brenchies/SurfsideSensors/schematics/hardware/Air Quality Sensor docs/PCB Wiring diagram back & front.jpg

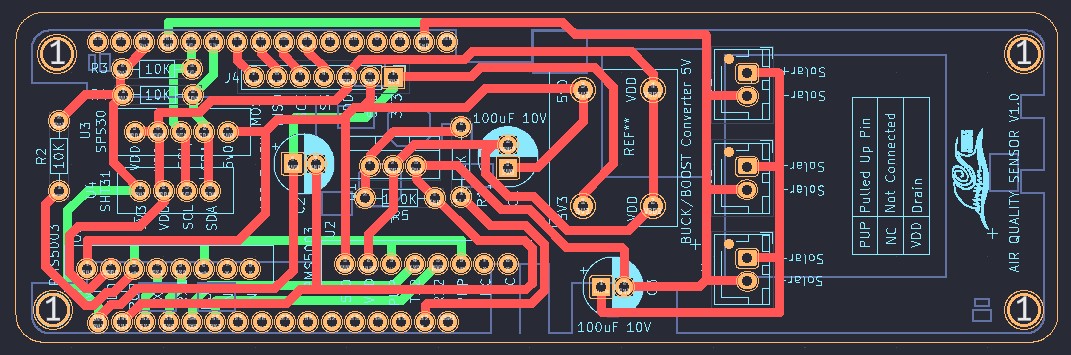
schematics/hardware/Air Quality Sensor docs/PCB Wiring diagram back & front.jpg
