brenchies/SurfsideSensors/schematics/hardware/Air Quality Sensor docs/Air Quality Sensor Wiring Fritzing_bbfinal.jpg

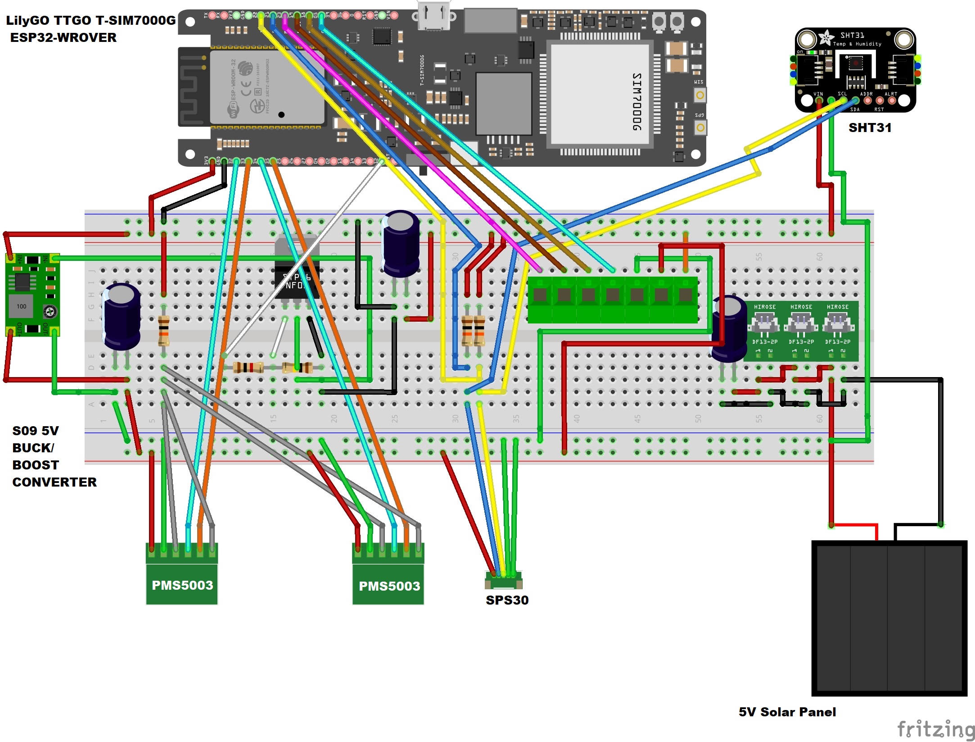
schematics/hardware/Air Quality Sensor docs/Air Quality Sensor Wiring Fritzing_bbfinal.jpg
