brenchies/SurfsideSensors/schematics/hardware/Air Quality Sensor docs/AQ CAD files/AQM (Stephen Design) (4).stl

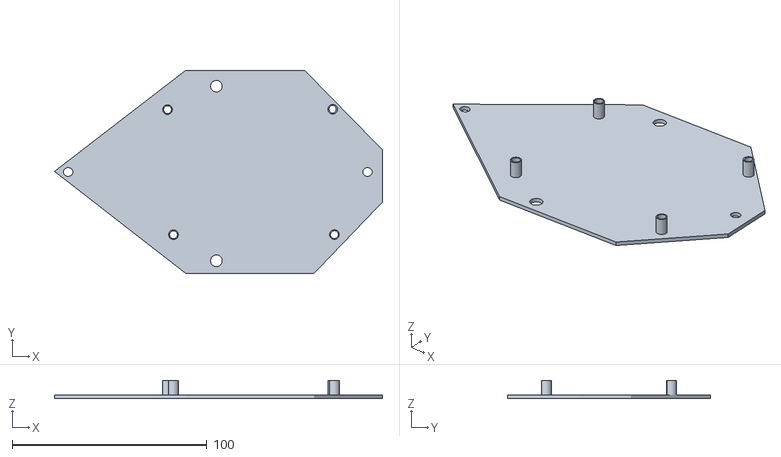
[picture p3: CAD file, 2023-05-29]
schematics/hardware/Air Quality Sensor docs/AQ CAD files/AQM (Stephen Design) (4).stl
168.4 x 104.0 x 9.50
