brenchies/SurfsideSensors/schematics/hardware/waterquality CAD files/WAP Top v4.stl

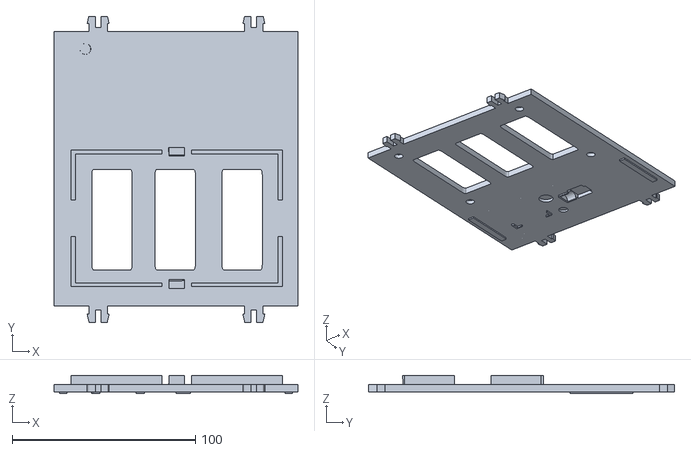
[picture p4: CAD file, 2023-05-29]
schematics/hardware/waterquality CAD files/WAP Top v4.stl
133.0 x 167.0 x 10.00
