brenchies/SurfsideSensors/schematics/hardware/waterquality CAD files/WAPv2 bottom plate v3(1).stl

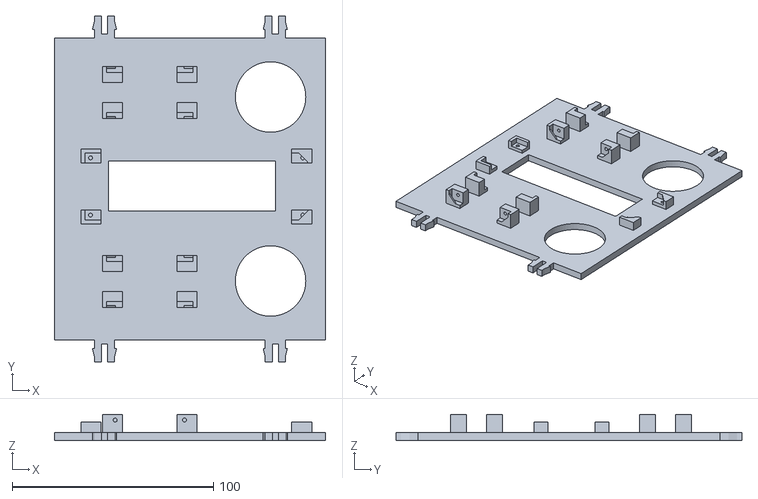
[picture p5: CAD file, 2023-05-29]
schematics/hardware/waterquality CAD files/WAPv2 bottom plate v3(1).stl
134.9 x 172.0 x 13.0
