brenchies/SurfsideSensors/schematics/hardware/waterquality CAD files/meta legs(1).stl

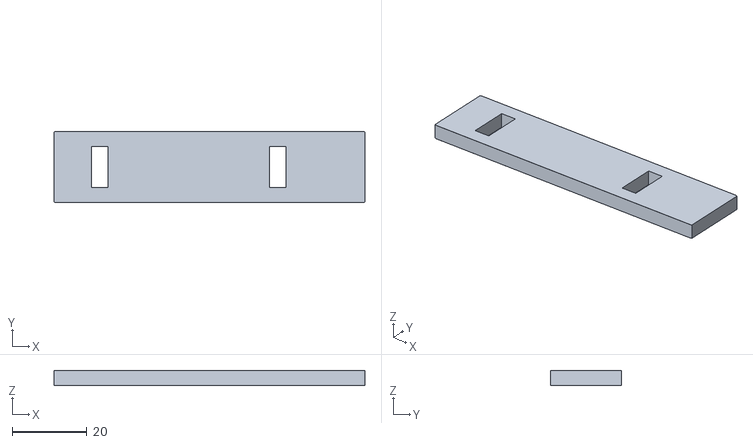
[picture p6: CAD file, 2023-05-29]
schematics/hardware/waterquality CAD files/meta legs(1).stl
83.2 x 19.0 x 4.00
