brenchies/SurfsideSensors/schematics/hardware/Air Quality Sensor docs/PCB Wiring diagram AQS [Components and pinouts].jpg

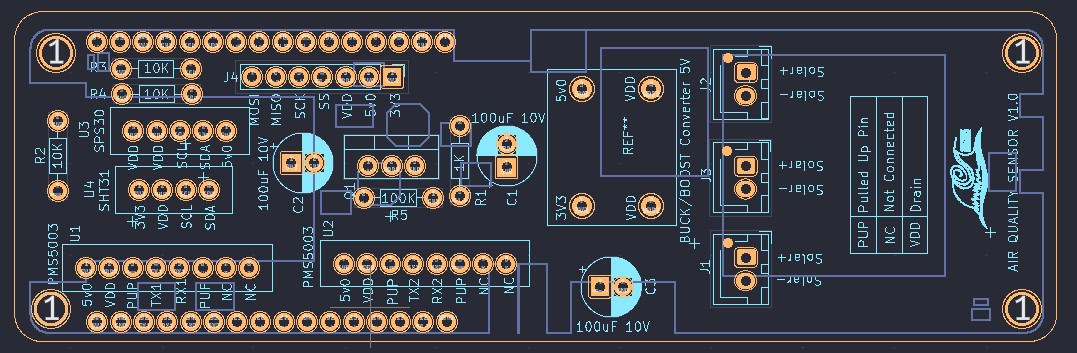
schematics/hardware/Air Quality Sensor docs/PCB Wiring diagram AQS [Components and pinouts].jpg
