brenchies/SurfsideSensors/schematics/hardware/Air Quality Sensor docs/PCB Wiring diagram back.jpg

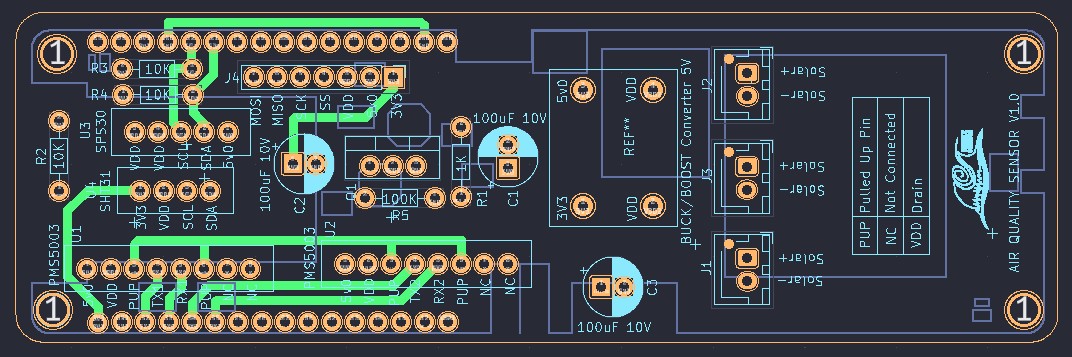
schematics/hardware/Air Quality Sensor docs/PCB Wiring diagram back.jpg
