brenchies/SurfsideSensors/schematics/hardware/waterquality CAD files/water_quality_shield_circuit_diagram.pdf

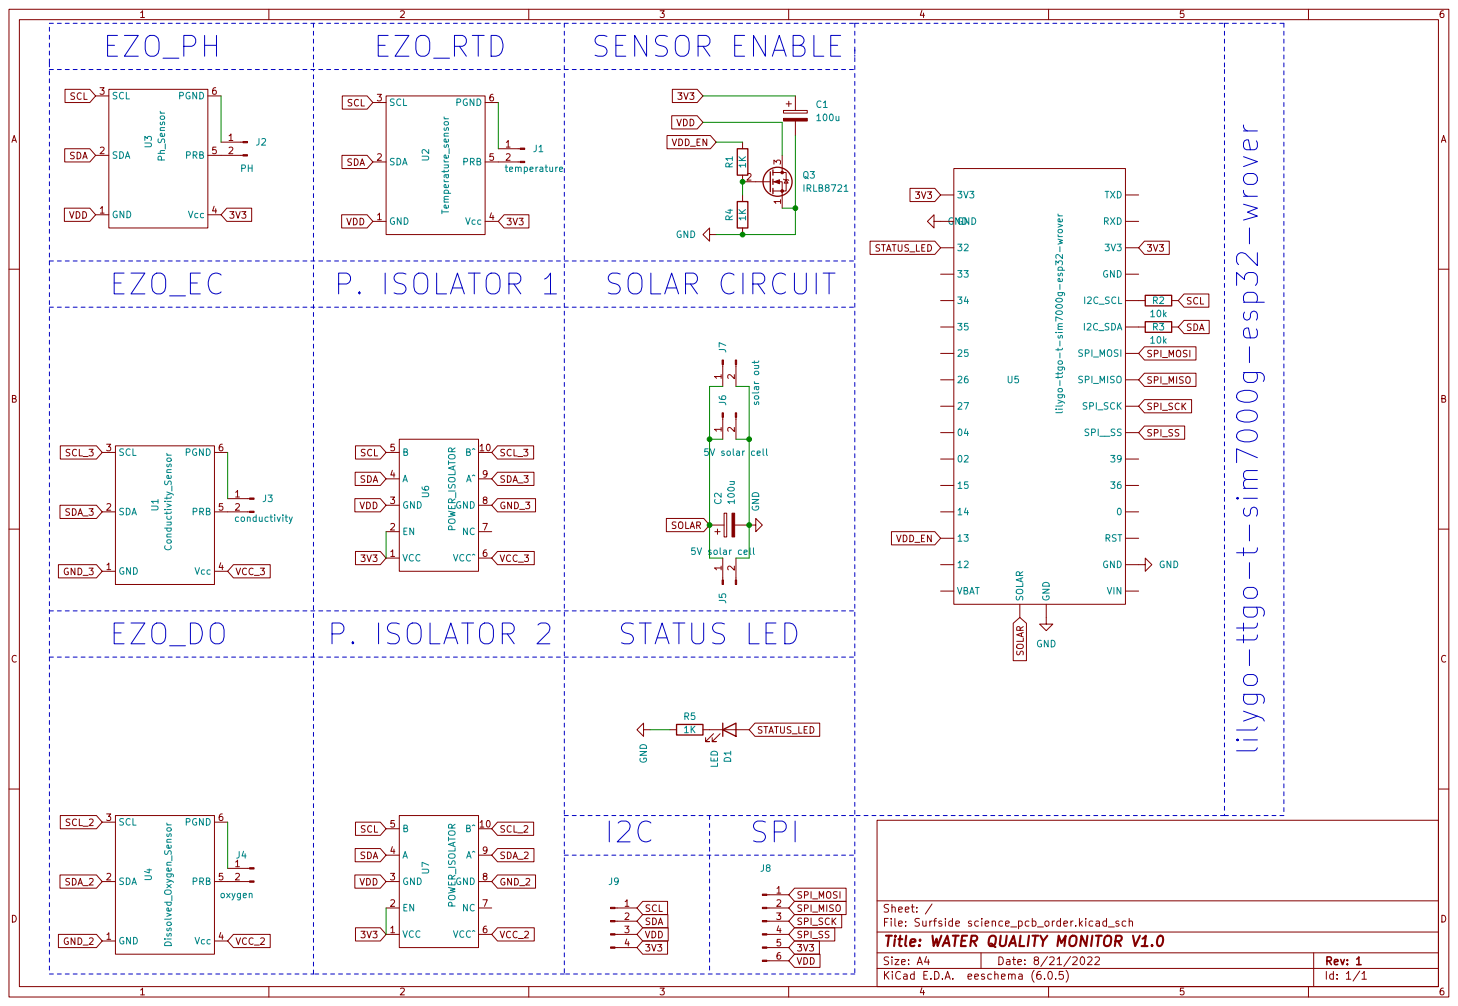
[picture p9: page 1]

GND 1 SDA 2 SCL 3 Vcc 4 PRB 5 PGND 6 U3 Ph_Sensor | GND 12

EZO_EC

EZO_DO | | J9 12 STATUS LED | J8 C2100u R5

3V3 VDD

SCL | SPI_MOSI SPI_SCK SPI_SS 3V3 VDD

Id: 1/1 Title: WATER QUALITY MONITOR V1.0
