brenchies/SurfsideSensors/schematics/software/Software architecture.pdf

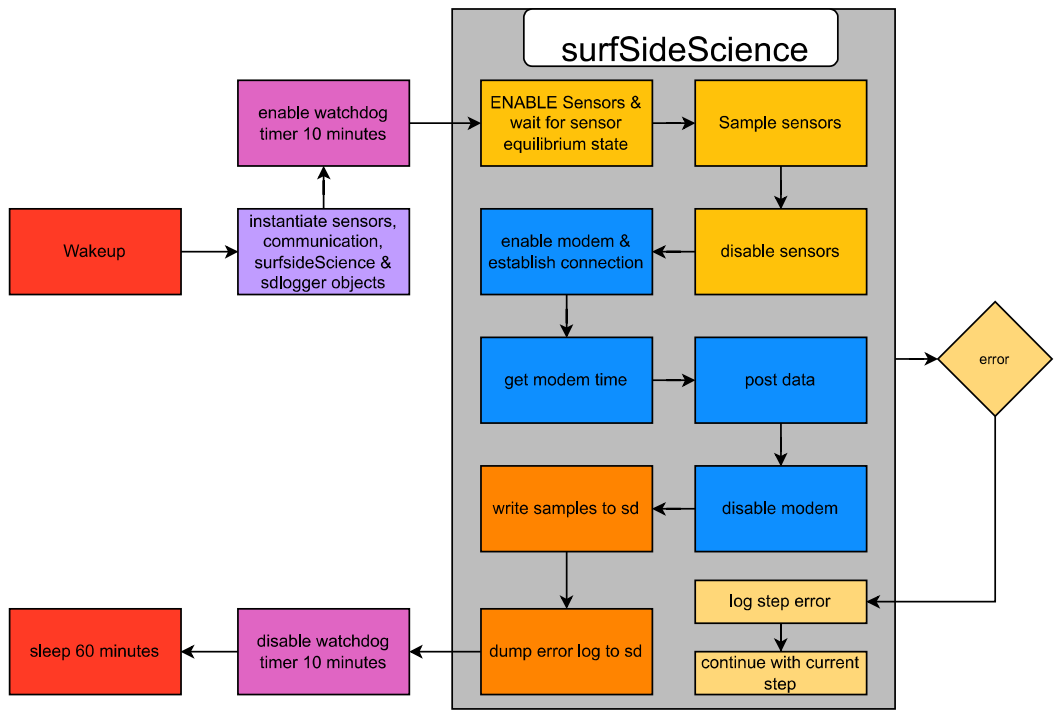
[picture p10: page 1]

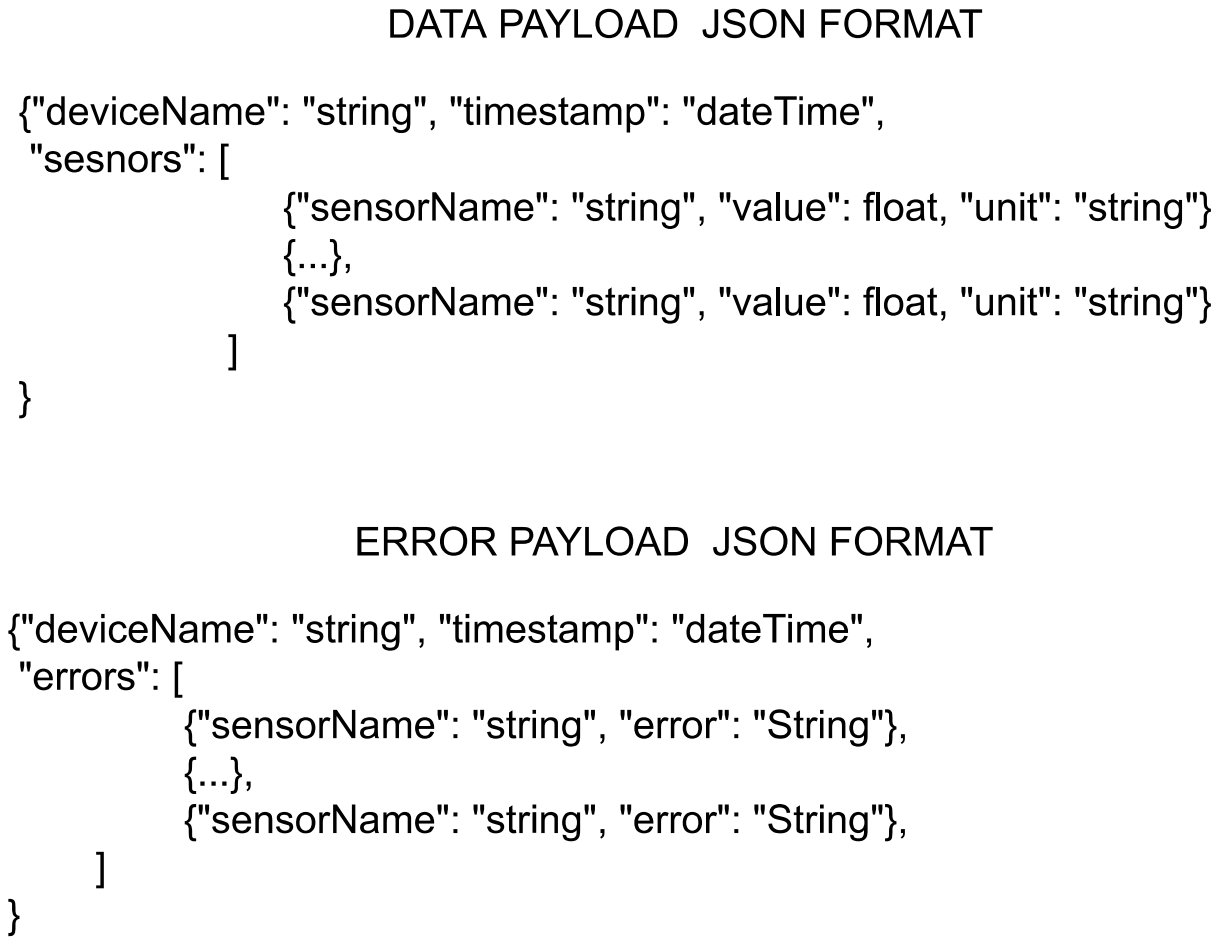
[picture p11: page 3]

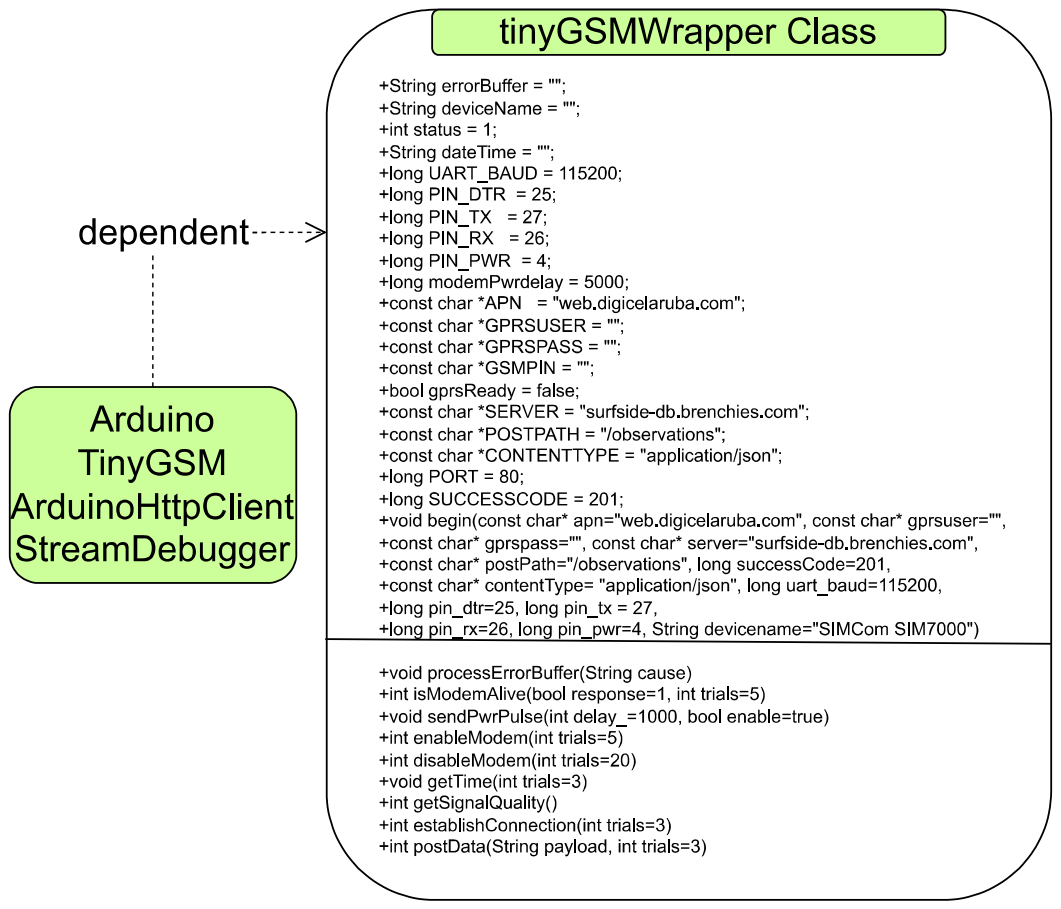
[picture p12: page 5]

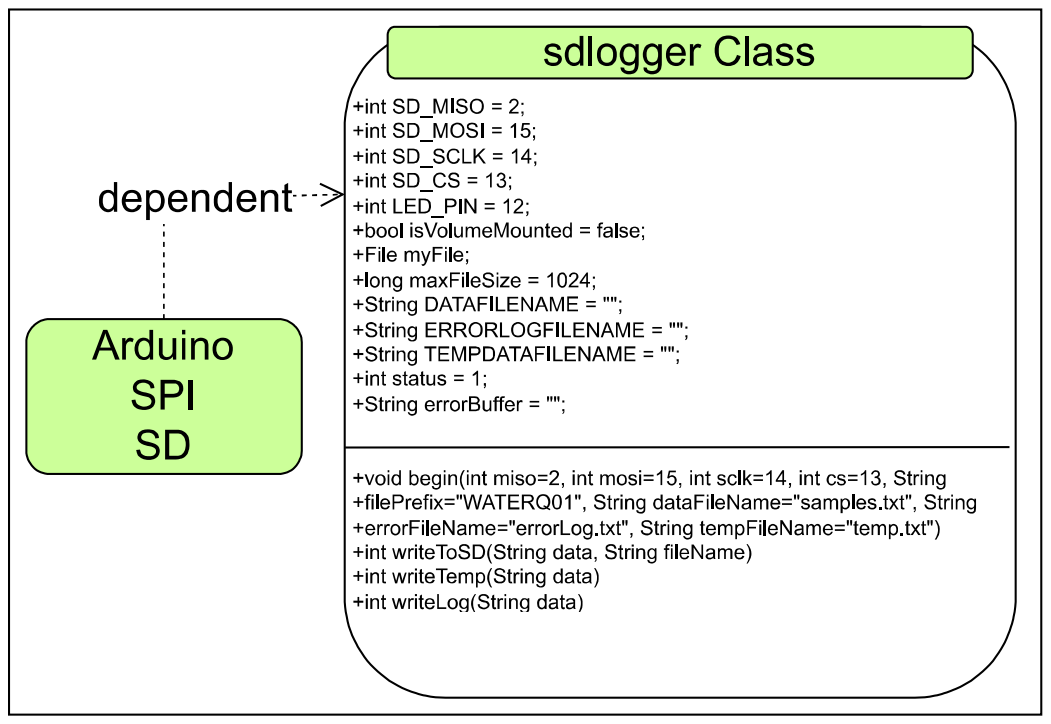
[picture p13: page 7]

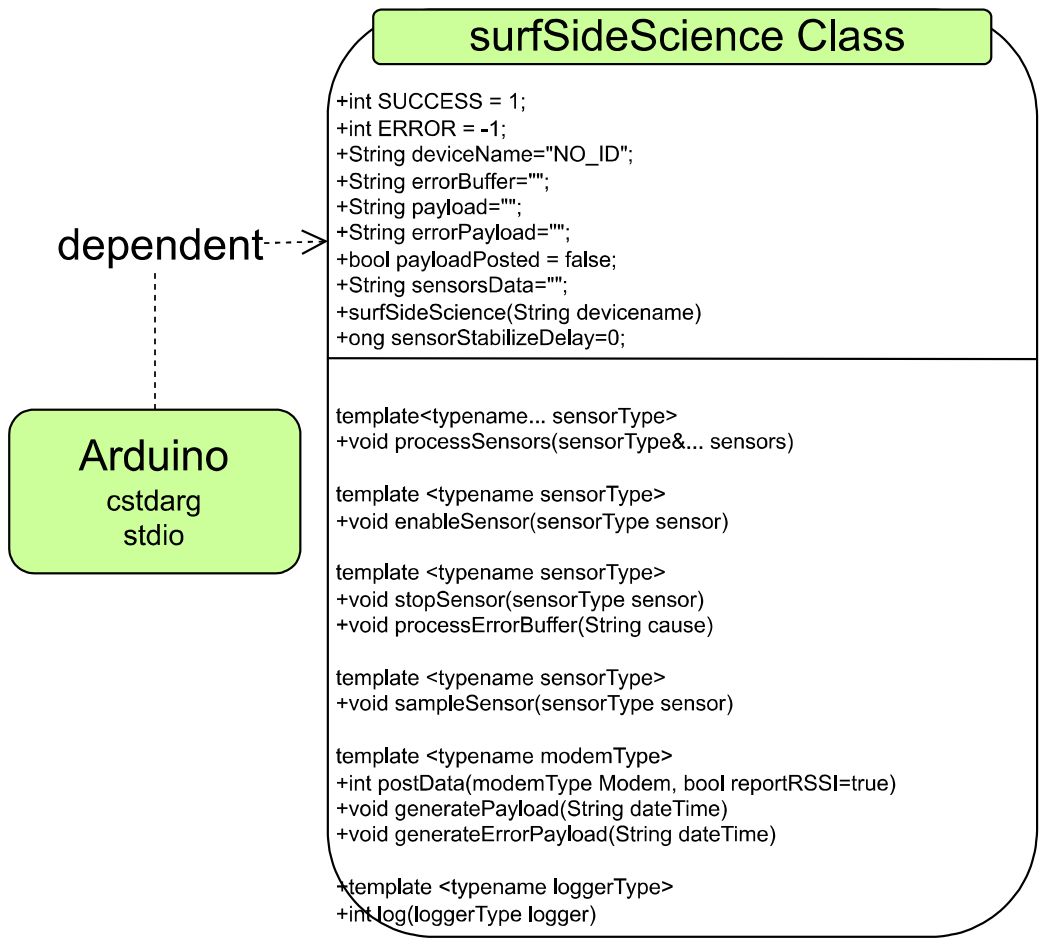
[picture p14: page 9]

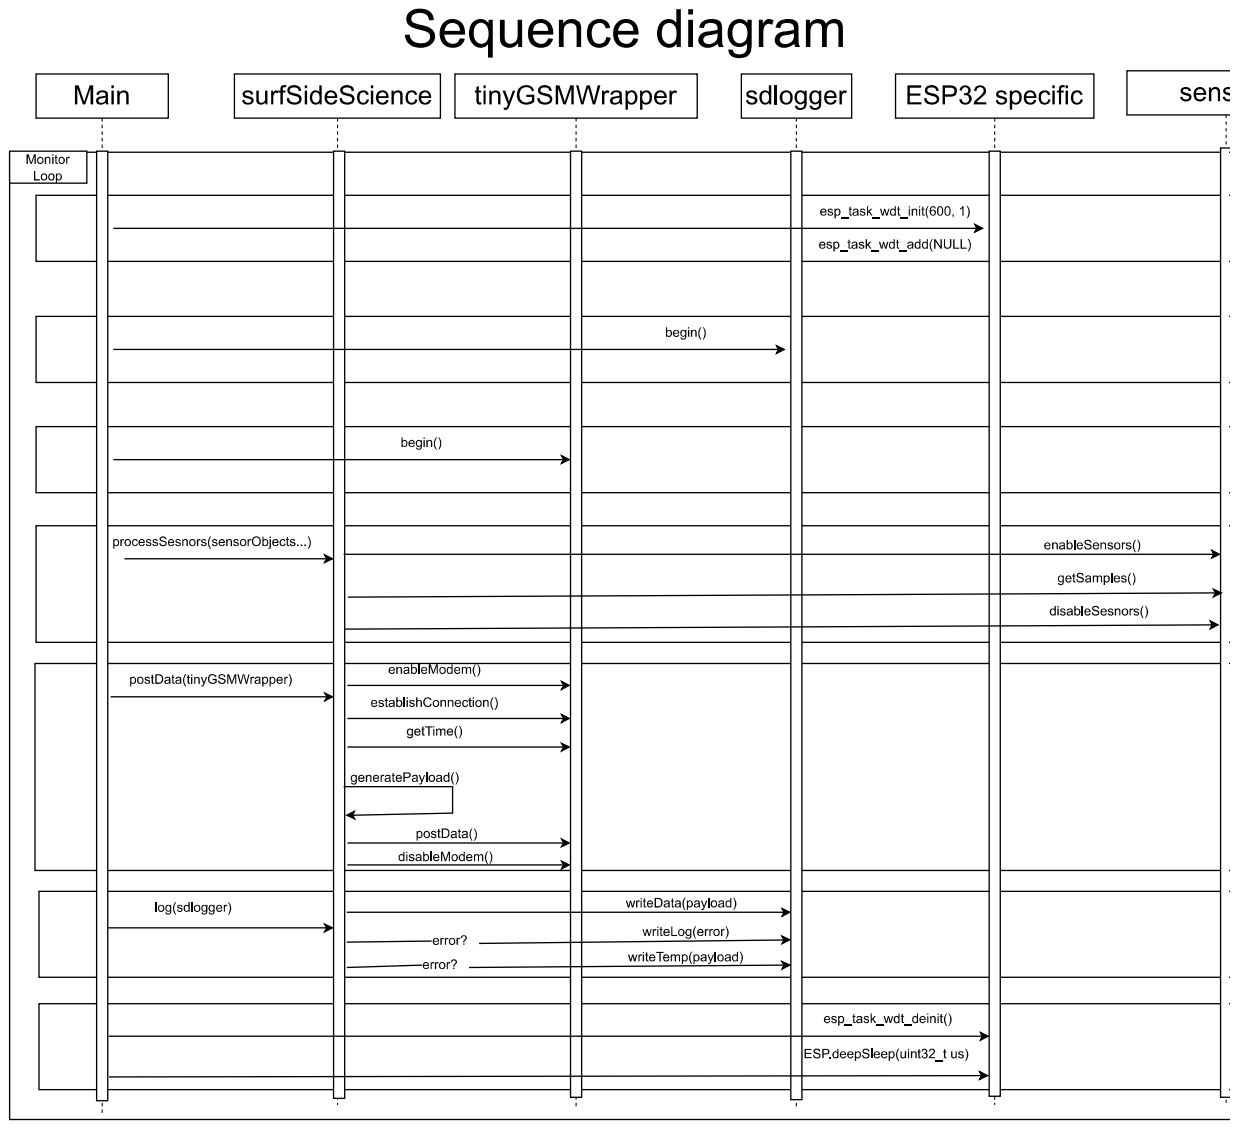
[picture p15: page 11]

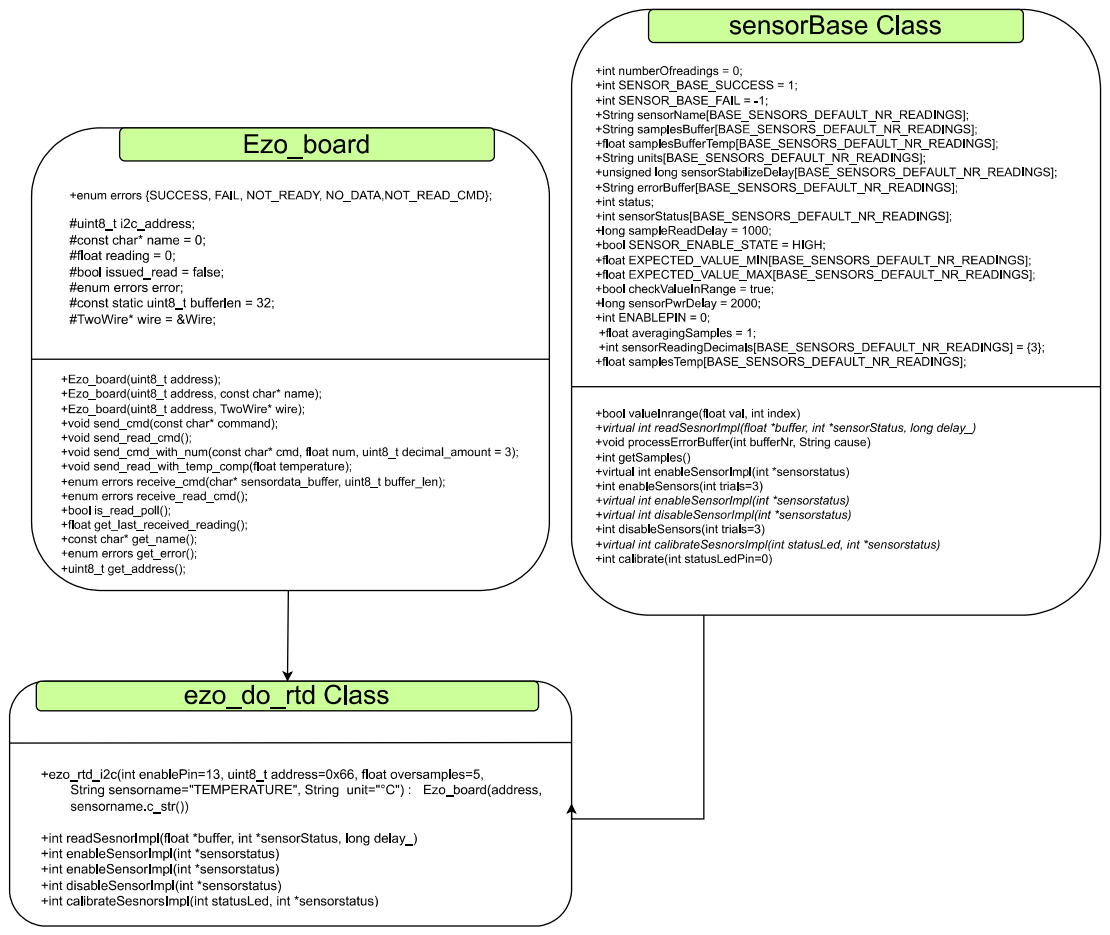
[picture p16: page 13]

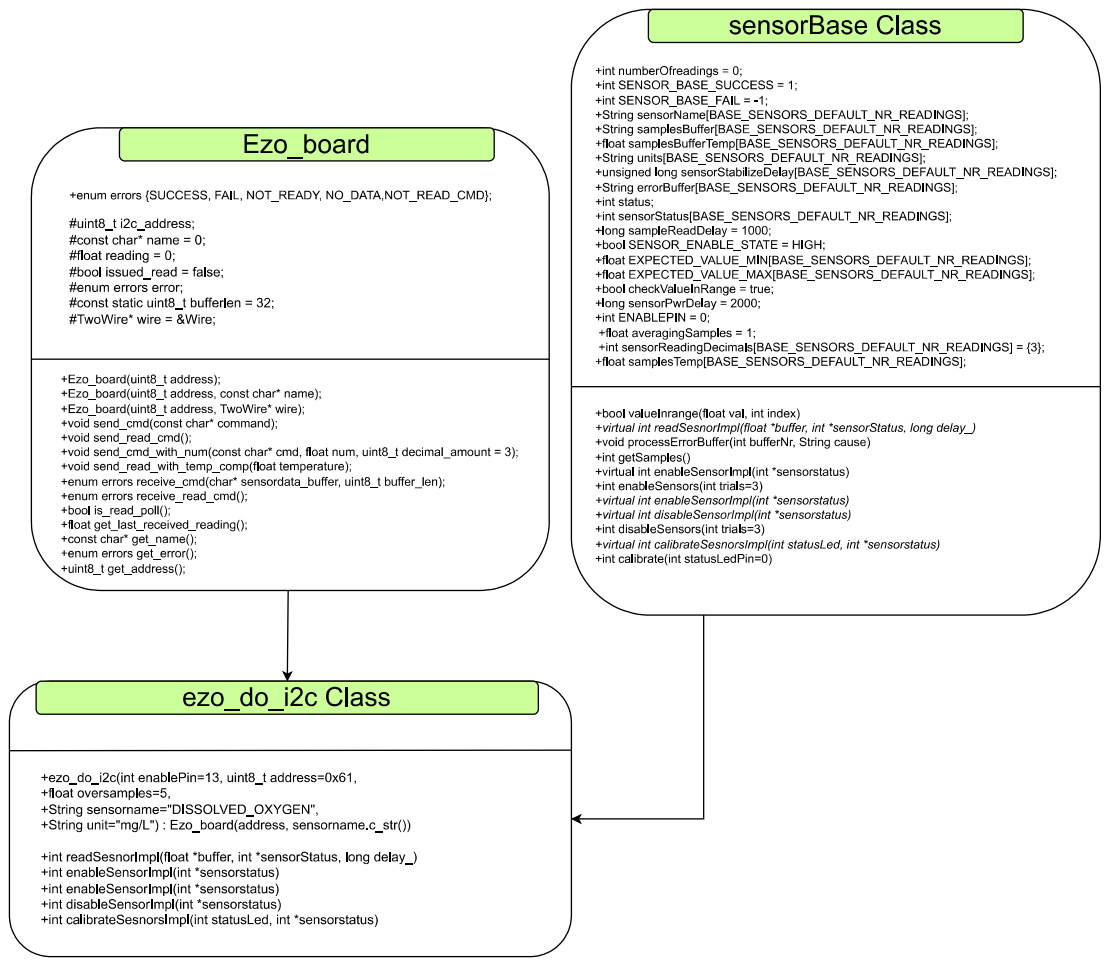
[picture p17: page 15]

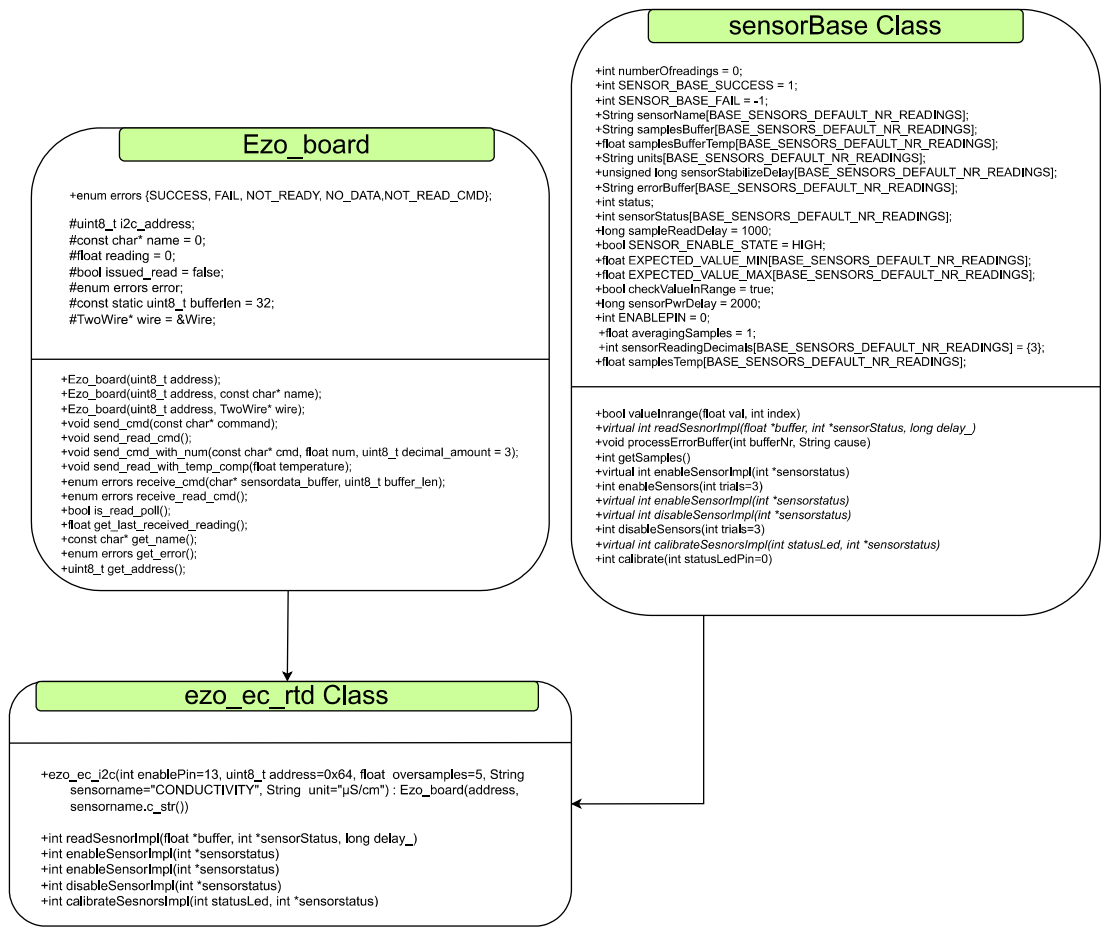
[picture p18: page 17]

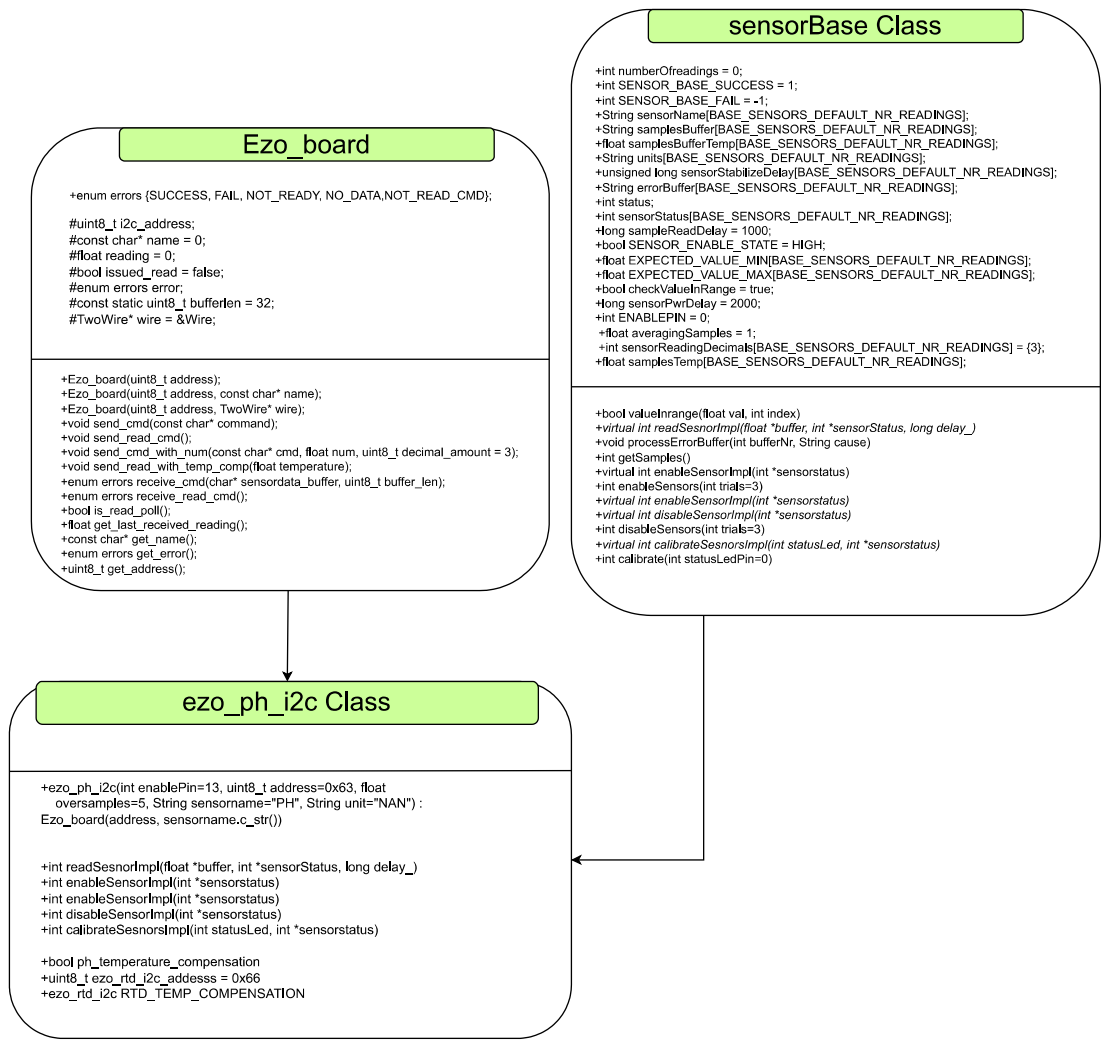
[picture p19: page 19]

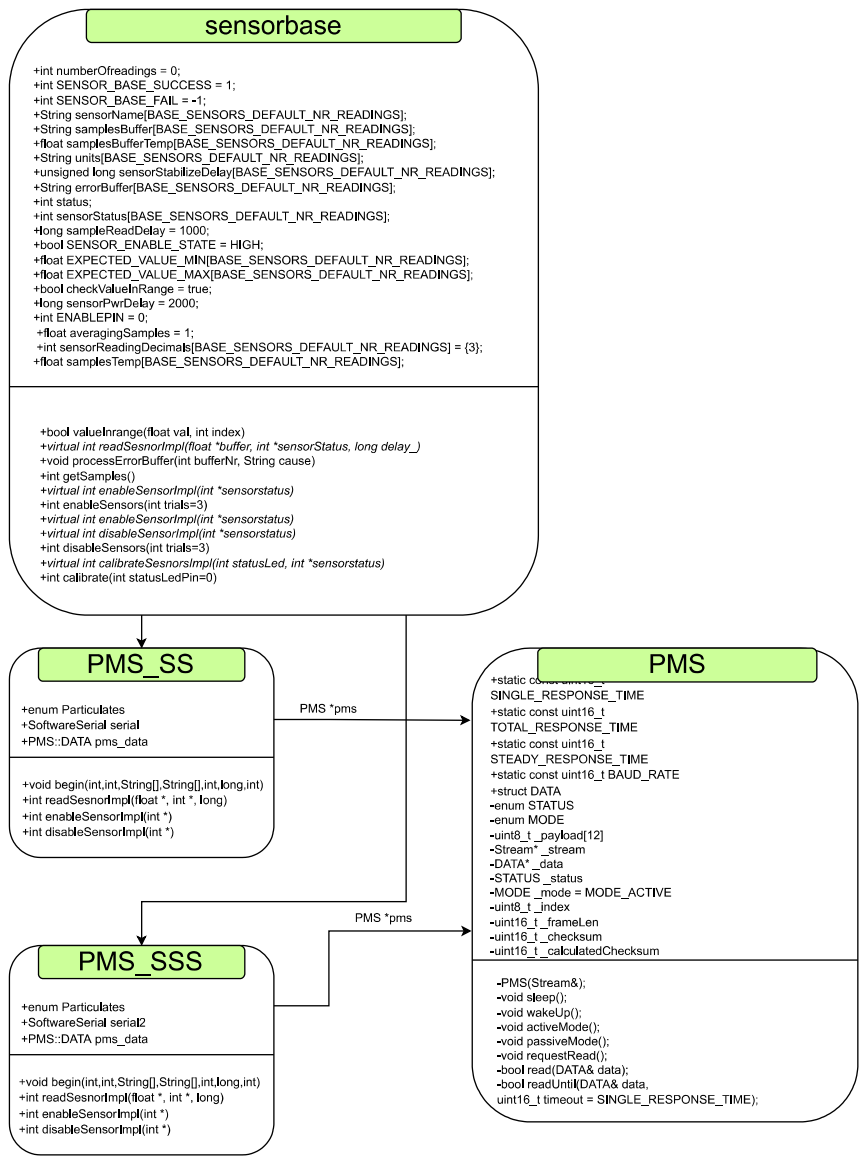
[picture p20: page 21]
