brenchies/SurfsideSensors/(commit log)

2022-08-04 Initial Push
    [Air Quality Sensor.fzz, AirQualitySensorBreakOutBoard.kicad_pcb, AirQualitySensorBreakOutBoard.kicad_sch, Untitled Sketch.fzz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]
2022-08-04 Adding AQS PCB files in AQS directory
    (Air Quality Sensor)
    [AirQualitySensorBreakOutBoard.kicad_pcb, AirQualitySensorBreakOutBoard.kicad_sch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]
2022-08-05 updated version
    [AirQualitySensorBreakOutBoard.kicad_pcb, AirQualitySensorBreakOutBoard.kicad_sch]
2022-09-01 Main update
    Final deliverables
    Readme
    examples
    instructions
    schematics
    [Air Quality Sensor.fzz, AirQualitySensorBreakOutBoard.kicad_pcb, AirQualitySensorBreakOutBoard.kicad_sch, Untitled Sketch.fzz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]
2022-09-01 waterquality gerber added
2022-09-01 Added AQS docs
    Schematic, gerber files, pcb kicad files
    [Air Quality Sensor Wiring Fritzing.fzz, AirQualitySensorBreakOutBoard.kicad_pcb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]
2022-09-07 Zipped PCB Files and Gerber Files of Air quality sensor
    [AirQualitySensorBreakOutBoard.kicad_pcb, AirQualitySensorBreakOutBoard.kicad_sch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]
2022-09-07 Compressed fritzing file to zip
    [Air Quality Sensor Wiring Fritzing.fzz]
2022-10-12 fix error template for sensor enabling and disabling
2022-11-30 Update airQuality.ino
    Changed device name to avoid accidental pollution of FAB data
    [airQuality.ino]
2023-05-29 Create 3D prints
